a2s-institute/open-robot-power-board/hardware/odri-power-board.kicad_pcb

## KiCad design hardware/odri-power-board.kicad_pcb (2024-06-13)

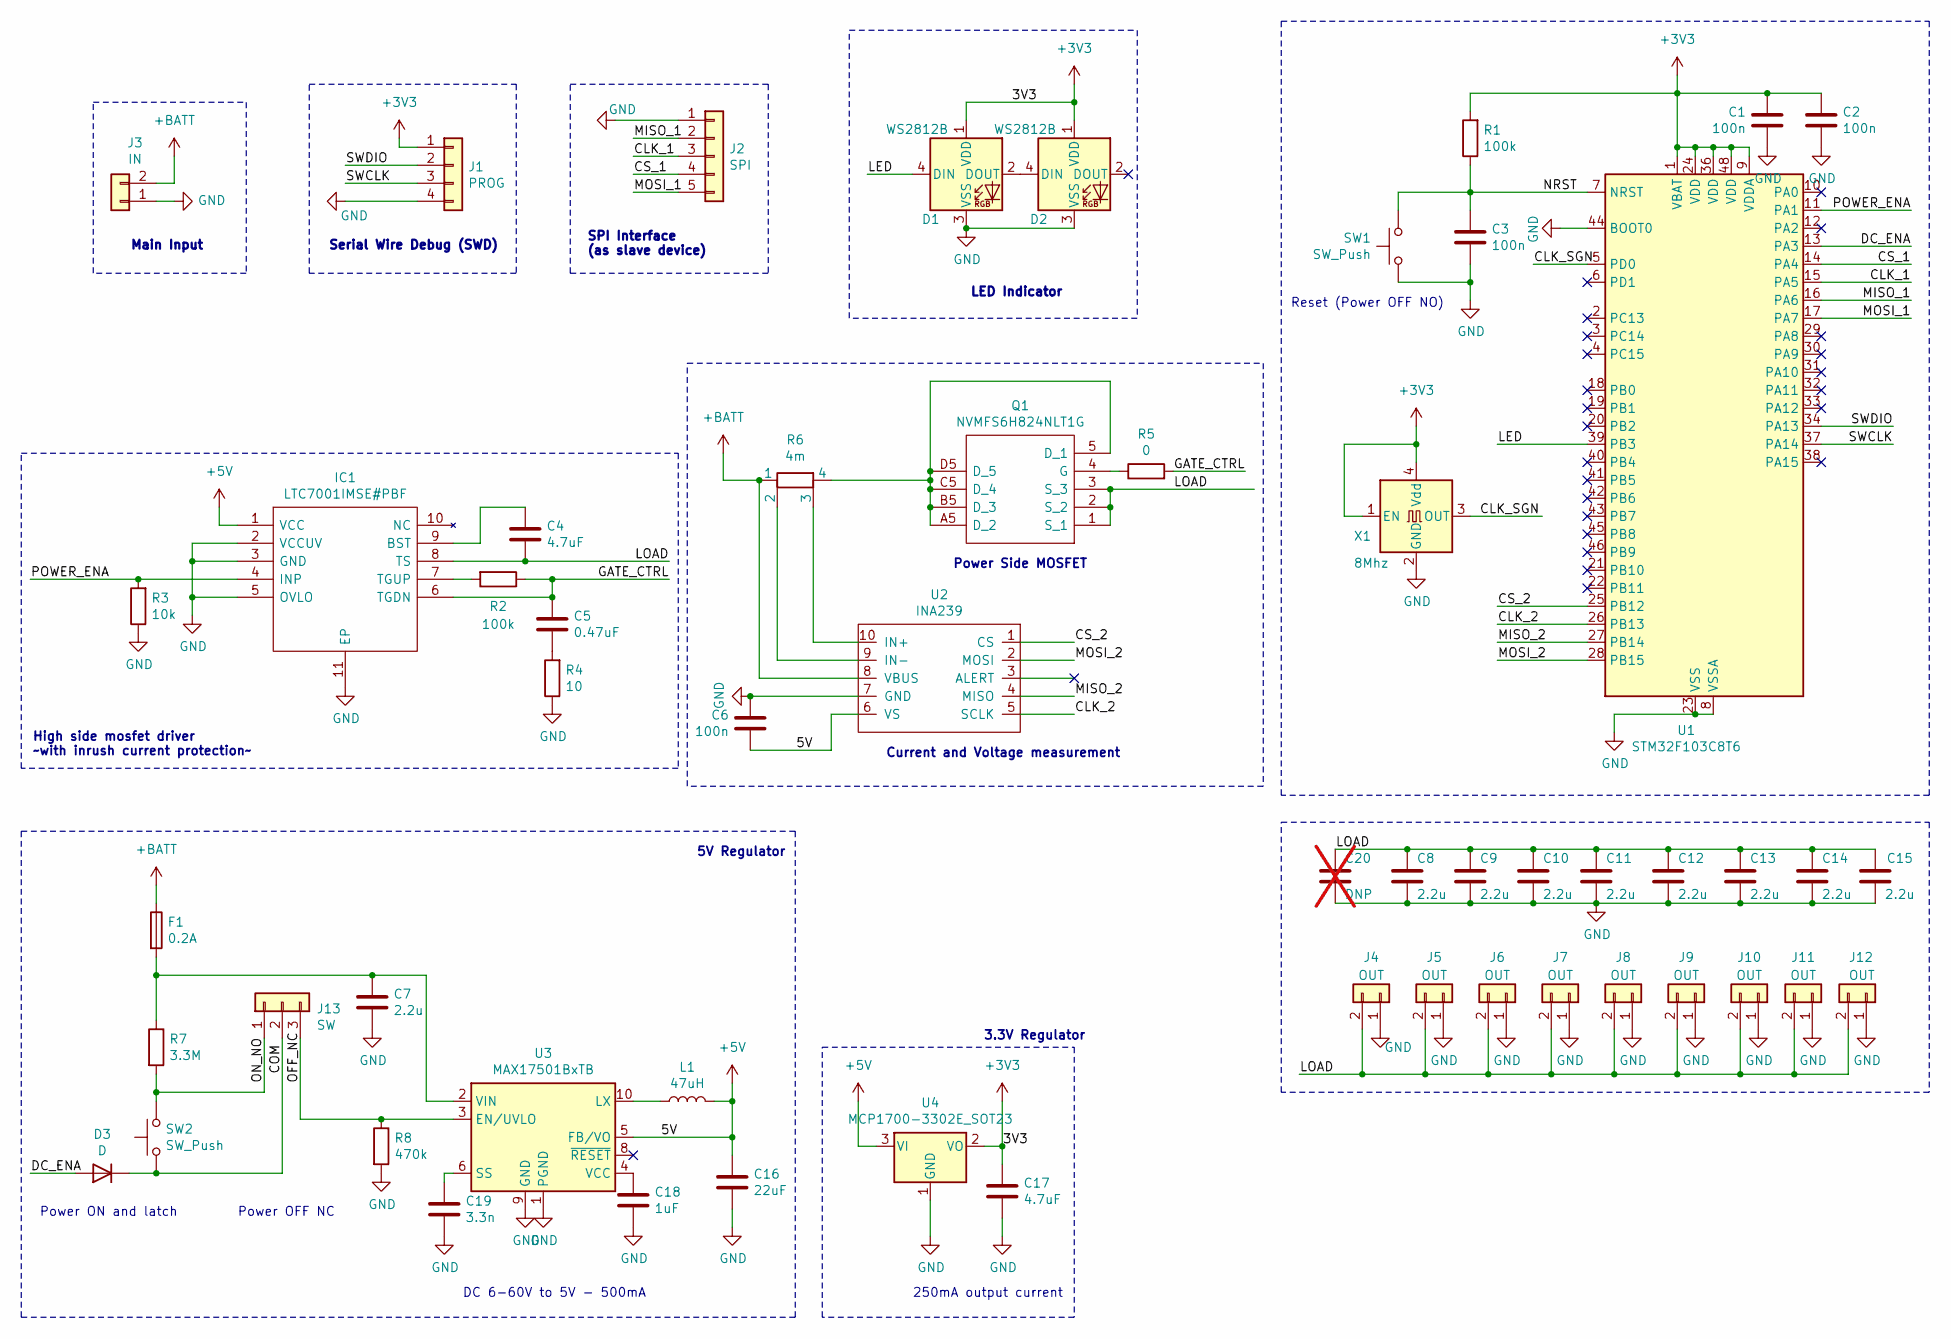
[picture p1: schematic odri-power-board.kicad_sch, ODRI Power Board]

Parts:
C1, C2, C3, C6: 100n; C_0402_1005Metric; Part No CC0402KRX7R7BB104; DigiKey 311-1338-1-ND
C4, C17: 4.7uF; C_0805_2012Metric; Part No GRM21BC71H475KE11L; DigiKey 490-12757-1-ND
C5: 0.47uF; C_0805_2012Metric; Part No CL21B474KBFNNNE; DigiKey 1276-1039-1-ND
C7, C8, C9, C10, C11, C12, C13, C14, C15: 2.2u; C_1206_3216Metric; Part No 12061C225K4T2A; DigiKey 478-12144-1-ND
C16: 22uF; C_0805_2012Metric; Part No CL21A226MPCLRNC; DigiKey 1276-1822-1-ND
C18: 1uF; C_0402_1005Metric; Part No 0402ZD105KAT2A; DigiKey 478-4596-1-ND
C19: 3.3n; C_0402_1005Metric; Part No CC0402KRX7R9BB332; DigiKey 311-1034-1-ND
C20: DNP; CP_Elec_4x5.8; not fitted
D1, D2: WS2812B; LED_WS2812B_PLCC4_5.0x5.0mm_P3.2mm; Part No COM-16347; DigiKey 1568-COM-16347CT-ND
D3: D; D_0402_1005Metric; Part No NSR05F20NXT5G; DigiKey NSR05F20NXT5GOSCT-ND
F1: 0.2A; Fuse_1206_3216Metric; Part No NANOSMDC020F-2; DigiKey NANOSMDC020F-2CT-ND
IC1: LTC7001IMSE#PBF; SOP50P490X110-11N; Part No LTC7001IMSE#PBF; DigiKey LTC7001IMSE#PBF-ND
J1: PROG; PinHeader_1x04_P2.54mm_Vertical
J2: SPI; Hirose_DF13-05P-1.25DSA_1x05_P1.25mm_Vertical; Part No DF13-5P-1.25DSA; DigiKey H2194-ND
J3: IN; AMASS_XT30PW-M_1x02_P2.50mm_Horizontal; Part No XT30PW-M
J4, J5, J6, J7, J8, J9, J10, J11, J12: OUT; AMASS_XT30U-M_1x02_P5.0mm_Vertical; Part No XT30U-M
J13: SW; Hirose_DF13-03P-1.25DSA_1x03_P1.25mm_Vertical; Part No DF13-3P-1.25DSA; DigiKey H2192-ND
L1: 47uH; L_Bourns-SRN4018; Part No LPS4018-473MRC; Farnell 2408111
Q1: NVMFS6H824NLT1G; NVMFS5C604NLWFT1G; Part No NVMFS6H824NLT1G; DigiKey 488-NVMFS6H824NLT1GCT-ND
R1, R2: 100k; R_0402_1005Metric; Part No RC0402FR-07100KL; DigiKey 311-100KLRCT-ND
R3: 10k; R_0402_1005Metric; Part No RC0402FR-0710KL; DigiKey 311-10.0KLRCT-ND
R4: 10; R_0402_1005Metric; Part No RC0402JR-0710RL; DigiKey 311-10JRCT-ND
R5: 0; R_0402_1005Metric; Part No CR0402-J/-000GLF; DigiKey CR0402-J/-000GLFCT-ND
R6: 4m; R_Shunt_Vishay_WSK2512_6332Metric_T2.66mm; Part No WSK25124L000FEA; DigiKey 541-WSK25124L000FEACT-ND
R7: 3.3M; R_0402_1005Metric; Part No RC0402FR-073M3L; DigiKey 311-3.30MLRCT-ND
R8: 470k; R_0402_1005Metric; Part No RC0402FR-07470KL; DigiKey 311-470KLRCT-ND
SW1, SW2: SW_Push; SW_Push_1P1T_NO_CK_KMR2; Part No KMR223GLFG; DigiKey 401-1428-1-ND
U1: STM32F103C8T6; LQFP-48_7x7mm_P0.5mm; Part No STM32F103C8T6; DigiKey 497-6063-ND
U2: INA239; VSSOP-10_3x3mm_P0.5mm; Part No INA239AIDGSR; Mouser 595-INA239AIDGSR
U3: MAX17501BxTB; TDFN-10-1EP_2x3mm_P0.5mm_EP0.9x2mm; Part No MAX17501BATB+T; DigiKey MAX17501BATB+TDKR-ND
U4: MCP1700-3302E_SOT23; SOT-23; Part No MCP1700T-3302E/TT; DigiKey MCP1700T3302ETTDKR-ND
X1: 8Mhz; Oscillator_SMD_Abracon_ASE-4Pin_3.2x2.5mm; Part No ASE-8.000MHZ-LC-T; DigiKey 535-9558-1-ND

Connections:
+3V3: C1.1, C2.1, C17.1, D1.1 (VDD), D2.1 (VDD), J1.1, R1.2, U1.1 (VBAT), U1.9 (VDDA), U1.24 (VDD), U1.36 (VDD), U1.48 (VDD), U4.2 (VO), X1.1 (EN), X1.4 (Vdd)
+5V: C6.2, C16.1, IC1.1 (VCC), L1.2, U2.6 (VS), U3.5 (FB/VO), U4.3 (VI)
+BATT: F1.1, J3.2, R6.1, U2.8 (VBUS)
/CLK_1: J2.3, U1.15 (PA5)
/CLK_2: U1.26 (PB13), U2.5 (SCLK)
/CLK_SGN: U1.5 (PD0), X1.3 (OUT)
/COM: D3.1 (K), J13.2, SW2.1
/CS_1: J2.4, U1.14 (PA4)
/CS_2: U1.25 (PB12), U2.1 (CS)
/DC_ENA: D3.2 (A), U1.13 (PA3)
/GATE_CTRL: C5.1, IC1.6 (TGDN), R2.1, R5.2
/LED: D1.4 (DIN), U1.39 (PB3)
/LOAD: C4.2, C8.1, C9.1, C10.1, C11.1, C12.1, C13.1, C14.1, C15.1, C20.1, IC1.8 (TS), J4.2, J5.2, J6.2, J7.2, J8.2, J9.2, J10.2, J11.2, J12.2, Q1.1 (S_1), Q1.2 (S_2), Q1.3 (S_3)
/MISO_1: J2.2, U1.16 (PA6)
/MISO_2: U1.27 (PB14), U2.4 (MISO)
/MOSI_1: J2.5, U1.17 (PA7)
/MOSI_2: U1.28 (PB15), U2.2 (MOSI)
/NRST: C3.1, R1.1, SW1.2, U1.7 (NRST)
/OFF_NC: J13.3, R8.1, U3.3 (EN/UVLO)
/ON_NO: J13.1, R7.2, SW2.2
/POWER_ENA: IC1.4 (INP), R3.2, U1.11 (PA1)
/SWCLK: J1.3, U1.37 (PA14)
/SWDIO: J1.2, U1.34 (PA13)
GND: C1.2, C2.2, C3.2, C6.1, C7.2, C8.2, C9.2, C10.2, C11.2, C12.2, C13.2, C14.2, C15.2, C16.2, C17.2, C18.2, C19.2, C20.2, D1.3 (VSS), D2.3 (VSS), IC1.2 (VCCUV), IC1.3 (GND), IC1.5 (OVLO), IC1.11 (EP), J1.4, J2.1, J3.1, J4.1, J5.1, J6.1, J7.1, J8.1, J9.1, J10.1, J11.1, J12.1, R3.1, R4.1, R8.2, SW1.1, U1.8 (VSSA), U1.23 (VSS), U1.35 (VSS), U1.44 (BOOT0), U1.47 (VSS), U2.7 (GND), U3.1 (PGND), U3.9 (GND), U3.11 (GND), U4.1 (GND), X1.2 (GND)
unnamed: C5.2, R4.2
unnamed: D1.2 (DOUT), D2.4 (DIN)
unnamed: C4.1, IC1.9 (BST)
unnamed: IC1.7 (TGUP), R2.2
unnamed: Q1.5 (D_1), Q1.A5 (D_2), Q1.B5 (D_3), Q1.C5 (D_4), Q1.D5 (D_5), R6.4
unnamed: Q1.4 (G), R5.1
unnamed: R6.3, U2.10 (IN+)
unnamed: R6.2, U2.9 (IN-)
unnamed: L1.1, U3.10 (LX)
unnamed: C19.1, U3.6 (SS)
unnamed: C18.1, U3.4 (VCC)
unnamed: C7.1, F1.2, R7.1, U3.2 (VIN)

Notes on the sheet:
DC 6-60V to 5V - 500mA
High side mosfet driver ~with inrush current protection~
3.3V Regulator
Power OFF NC
Reset (Power OFF NO)
LED Indicator
Main Input
SPI Interface (as slave device)
Power Side MOSFET
5V Regulator
Current and Voltage measurement
Power ON and latch
Serial Wire Debug (SWD)
250mA output current

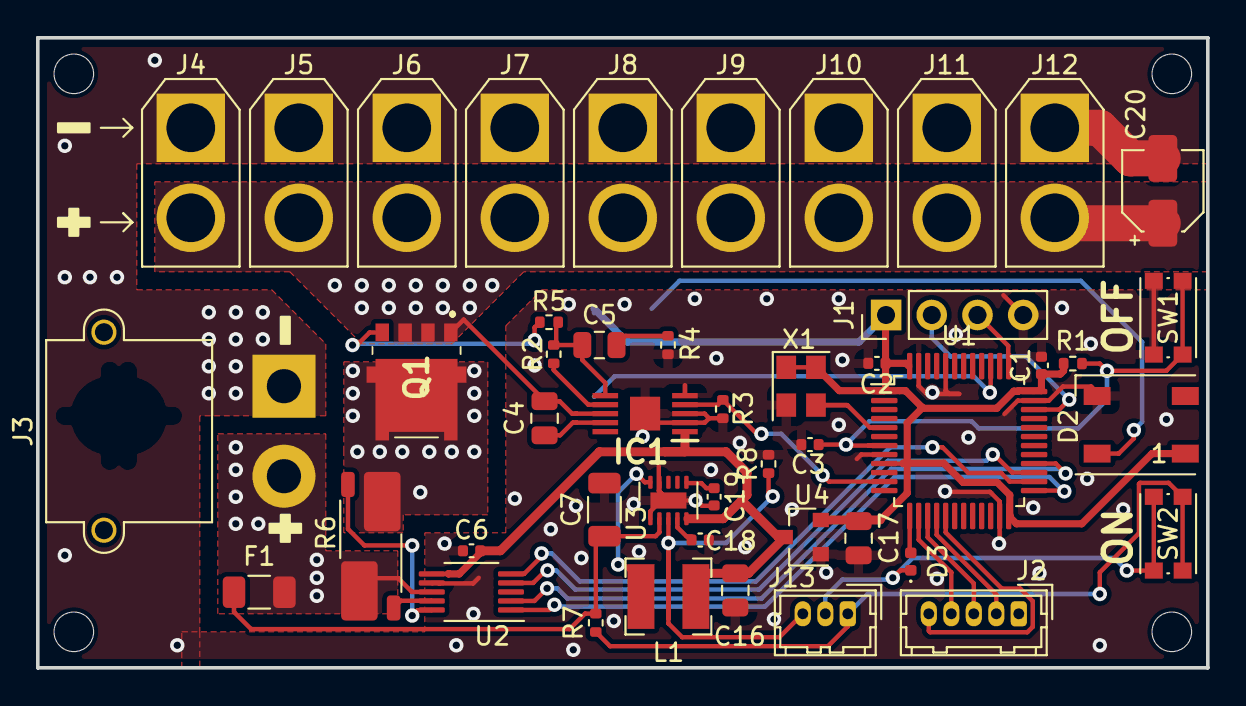
[picture p2: board odri-power-board.kicad_pcb from above]

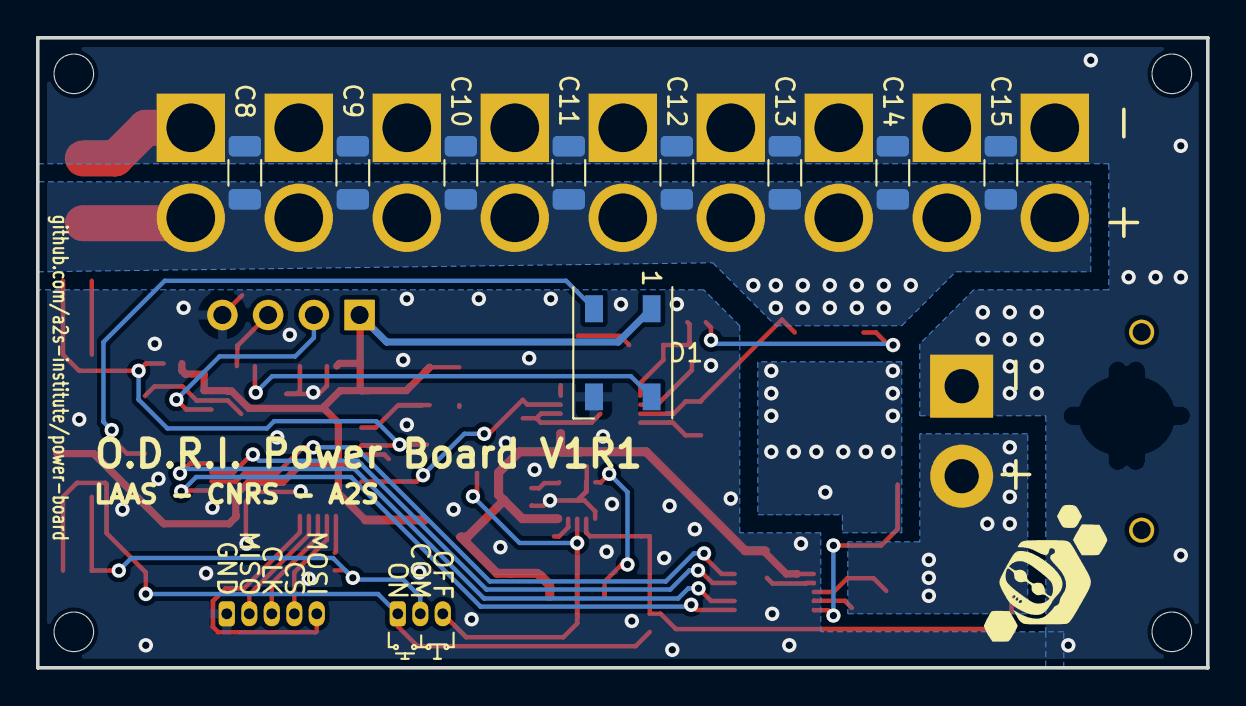
[picture p3: board odri-power-board.kicad_pcb from below]

Board: 2 copper layers, 65.0 x 35.0 mm, 55 parts (9 on the bottom side), 36 nets.
