a2s-institute/open-robot-power-board/(commit log)

2024-06-12 Harley's revision
    [odri-power-board.kicad_pcb, odri-power-board.kicad_sch]
2024-06-12 export bom
2024-06-13 add mounting holes and silkscreen
    [odri-power-board.kicad_pcb, odri-power-board.kicad_sch]
2024-06-13 add schematic to artifacts
